JDanen/GBS8200-reverse/README.md

[ This repo is under construction ] 

An attempt to trace out a schematic for the GBS8200 upscaler board in KiCAD. 

No licence has been selected at the time of creating this repo - will be addressed when time permits

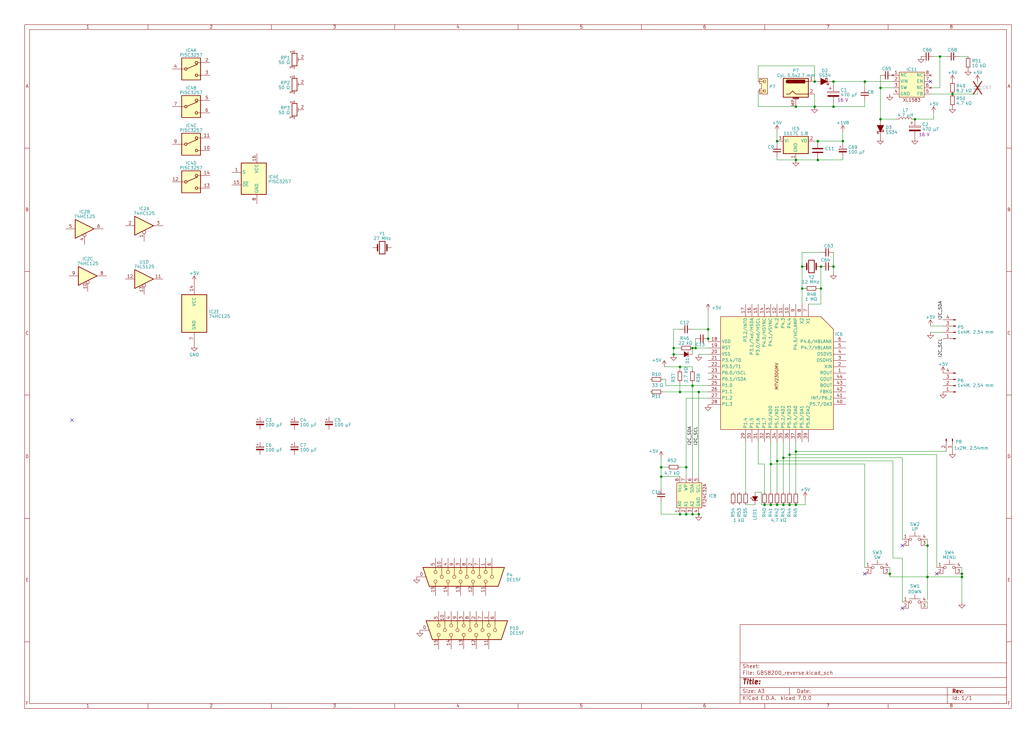
[picture p1: schematic.png]
