JDanen/GBS8200-reverse/GBS8200_power.kicad_sch

## KiCad design GBS8200_power.kicad_sch (2023-06-04)

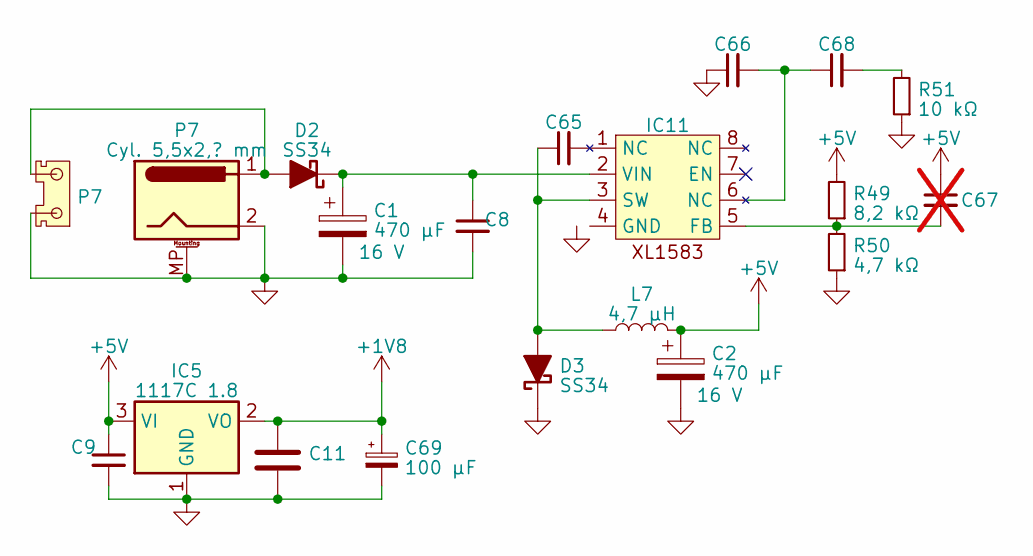
[picture p2: schematic GBS8200_power.kicad_sch]

Parts:
C1, C2: 470 μF; Voltage 16 V
C8, C9, C11, C65, C66, C68: (no value)
C67: not fitted
C69: 100 μF; Voltage 16 V
D2, D3: SS34
IC5: 1117C 1.8; SOT-223-3_TabPin2
IC11: (no value)
L7: 4,7 μH
P7: Cyl. 5,5x2,? mm
R49: 8,2 kΩ
R50: 4,7 kΩ
R51: 10 kΩ

Connections:
+1V8: C11.1, C69.1, IC5.2 (VO)
+5V: C2.1, C9.1, C67.1, IC5.3 (VI), L7.2, R49.2
GND: C1.2, C2.2, C8.2, C9.2, C11.2, C66.1, C69.2, D3.1 (K), IC5.1 (GND), P7., P7.2, P7.MP (MountPin), R50.1, R51.1
unnamed: C1.1, C8.1, D2.1 (K), IC11.2 (VIN)
unnamed: C65.1, D3.2 (A), IC11.3 (SW), L7.1
unnamed: C65.2, IC11.1 (NC)
unnamed: C66.2, C68.1, IC11.6 (NC)
unnamed: C67.2, IC11.5 (FB), R49.1, R50.2
unnamed: C68.2, R51.2
unnamed: D2.2 (A), P7., P7.1
