JDanen/GBS8200-reverse/GBS8200_reverse.kicad_sch

## KiCad design GBS8200_reverse.kicad_sch (2023-06-04, an earlier design)

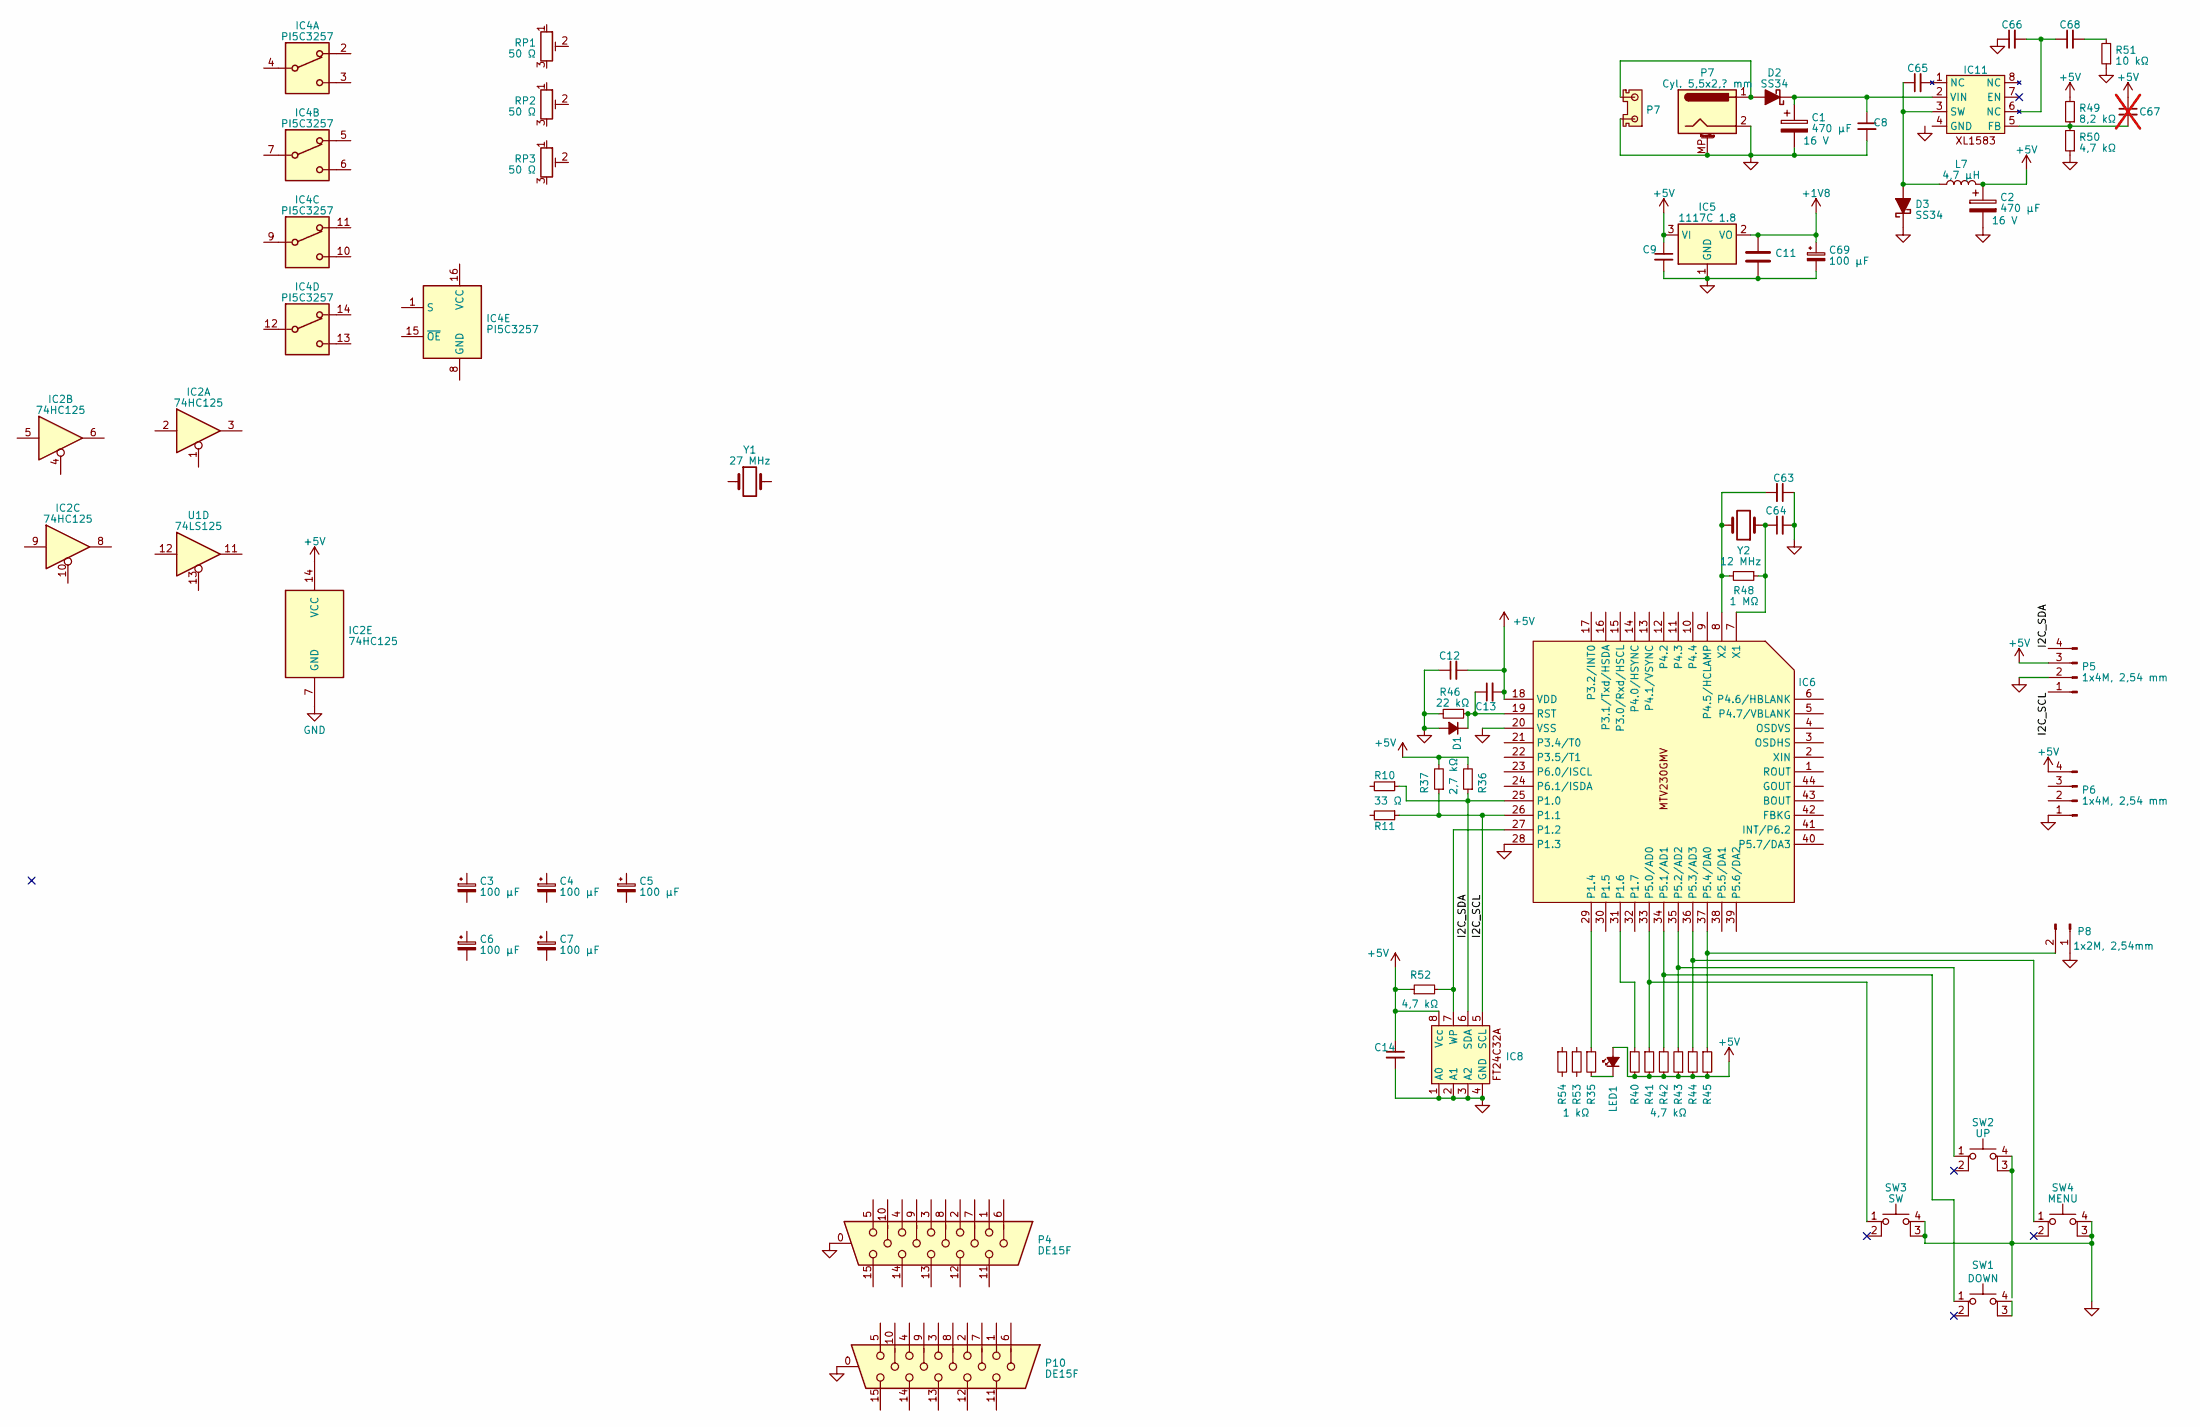
[picture p3: schematic GBS8200_reverse.kicad_sch]

Parts:
C1, C2: 470 μF; Voltage 16 V
C3, C4, C5, C6, C7, C69: 100 μF; Voltage 16 V
C8, C9, C11, C12, C13, C14, C63, C64, C65, C66, C68: (no value)
C67: not fitted
D1: (no value)
D2, D3: SS34
IC2: 74HC125
IC4: PI5C3257
IC5: 1117C 1.8; SOT-223-3_TabPin2
IC6, IC8, IC11: (no value)
L7: 4,7 μH
LED1: (no value)
P4, P10: DE15F
P5, P6: 1x4M, 2,54 mm
P7: Cyl. 5,5x2,? mm
P8: 1x2M, 2,54mm
R10, R11: 33 Ω
R35, R53, R54: 1 kΩ
R36, R37: 2,7 kΩ
R40, R41, R42, R43, R44, R45, R50, R52: 4,7 kΩ
R46: 22 kΩ
R48: 1 MΩ
R49: 8,2 kΩ
R51: 10 kΩ
RP1, RP2, RP3: 50 Ω
SW1: DOWN
SW2: UP
SW3: SW
SW4: MENU
U1: 74LS125
Y1: 27 MHz
Y2: 12 MHz

Connections:
+1V8: C11.1, C69.1, IC5.2 (VO)
+5V: C2.1, C9.1, C12.2, C13.2, C14.1, C67.1, IC2.14 (VCC), IC5.3 (VI), IC6.18 (VDD), IC8.8 (Vcc), L7.2, LED1.2 (A), P5.3, P6.4, R36.2, R37.2, R40.2, R41.2, R42.2, R43.1, R44.2, R45.2, R49.2, R52.1
GND: C1.2, C2.2, C8.2, C9.2, C11.2, C12.1, C14.2, C63.1, C64.2, C66.1, C69.2, D1.2 (A), D3.1 (K), IC2.7 (GND), IC5.1 (GND), IC6.20 (VSS), IC6.28 (P1.3), IC8.1 (A0), IC8.2 (A1), IC8.3 (A2), IC8.4 (GND), P4.0, P5.2, P6.1, P7., P7.2, P7.MP (MountPin), P8.1, P10.0, R46.2, R50.1, R51.1, SW2.3 (K), SW2.4 (A), SW3.3 (K), SW3.4 (A), SW4.3 (K), SW4.4 (A)
I2C_SCL: IC6.26 (P1.1), IC8.5 (SCL), P5.1, R11.1, R37.1
I2C_SDA: IC6.25 (P1.0), IC8.6 (SDA), P5.4, R10.1, R36.1
unnamed: C1.1, C8.1, D2.1 (K), IC11.2 (VIN)
unnamed: C13.1, D1.1 (K), IC6.19 (RST), R46.1
unnamed: C63.2, IC6.8 (X2), R48.2, Y2.2
unnamed: C64.1, IC6.7 (X1), R48.1, Y2.1
unnamed: C65.1, D3.2 (A), IC11.3 (SW), L7.1
unnamed: C65.2, IC11.1 (NC)
unnamed: C66.2, C68.1, IC11.6 (NC)
unnamed: C67.2, IC11.5 (FB), R49.1, R50.2
unnamed: C68.2, R51.2
unnamed: D2.2 (A), P7., P7.1
unnamed: IC6.27 (P1.2), IC8.7 (WP), R52.2
unnamed: IC6.29 (P1.4), R35.1
unnamed: IC6.31 (P1.6), R40.1
unnamed: IC6.33 (P5.0/AD0), R41.1, SW3.1
unnamed: IC6.34 (P5.1/AD1), R42.1, SW1.1
unnamed: IC6.35 (P5.2/AD2), R43.2, SW2.1
unnamed: IC6.36 (P5.3/AD3), R44.1, SW4.1
unnamed: IC6.37 (P5.4/DA0), P8.2, R45.1
unnamed: LED1.1 (K), R35.2
unnamed: SW1.3 (K), SW1.4 (A)
