JDanen/GBS8200-reverse/(commit log)

2023-03-22 the scheming has begun
    [GBS8200_reverse.kicad_pcb, GBS8200_reverse.kicad_sch]
2023-03-22 added schematic png
2023-06-04 Added SDRAM and video in/out connectors
    [GBS8200_power.kicad_sch, GBS8200_reverse.kicad_sch]
